Senior-Design-ZotPonics/Documentation/images/T-Cobbler2.jpg

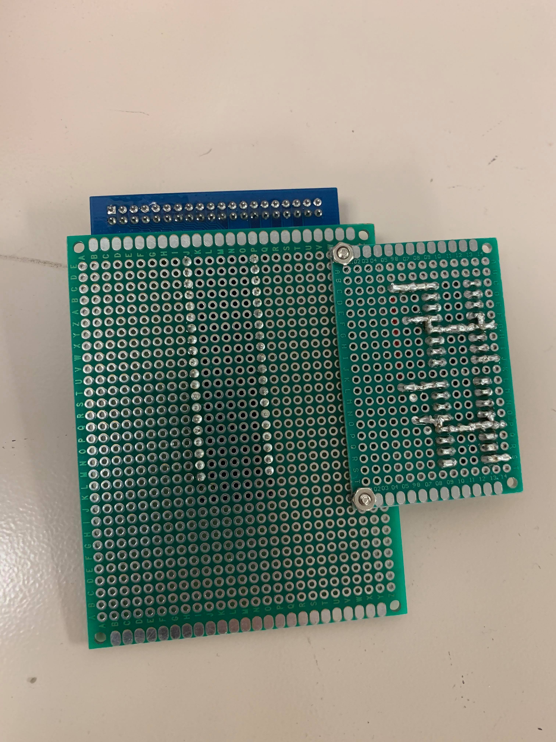
images/T-Cobbler2.jpg
