Senior-Design-ZotPonics/Documentation/T-Cobbler1.jpg

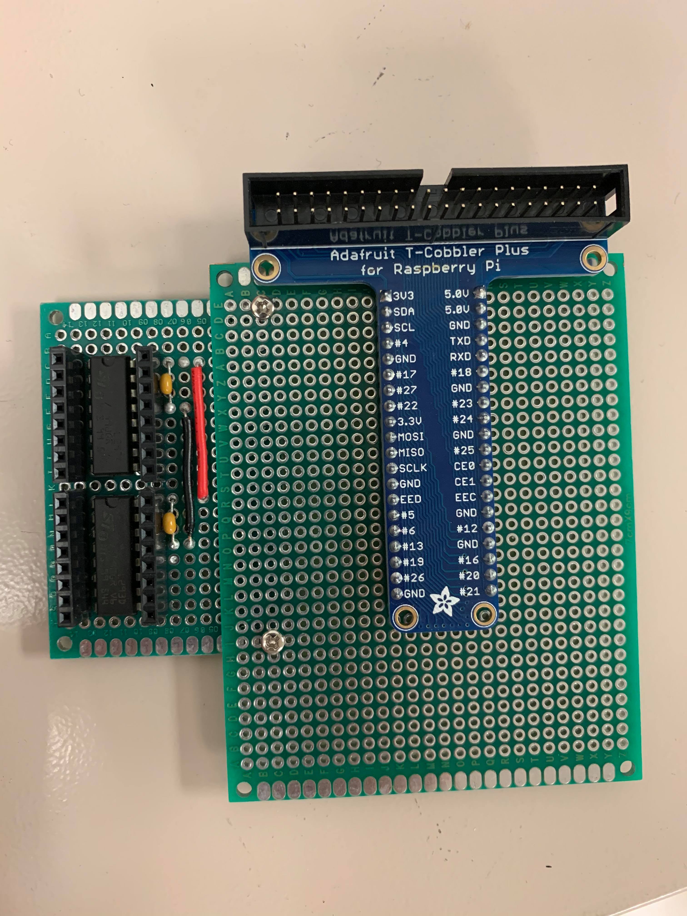
T-Cobbler1.jpg
