Senior-Design-ZotPonics/Documentation/App Hierarchy.png

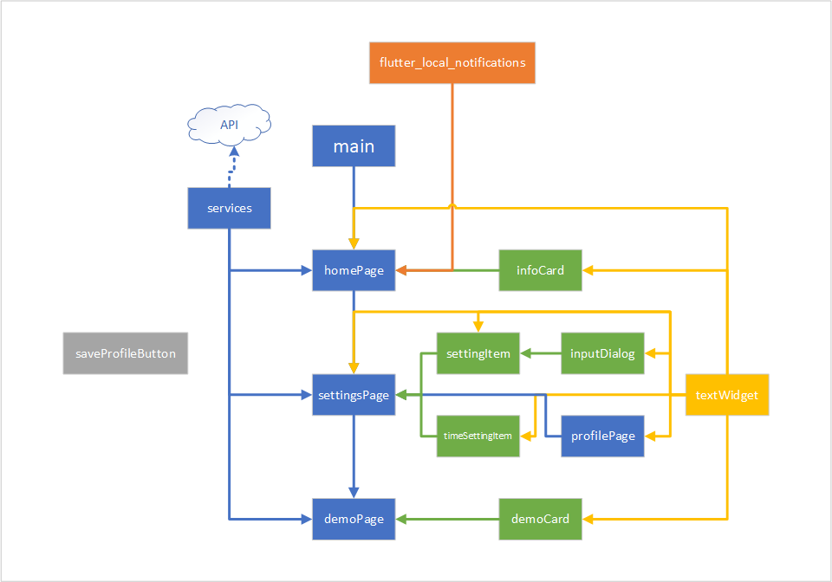
App Hierarchy.png
