Senior-Design-ZotPonics/Documentation/App Recording.gif

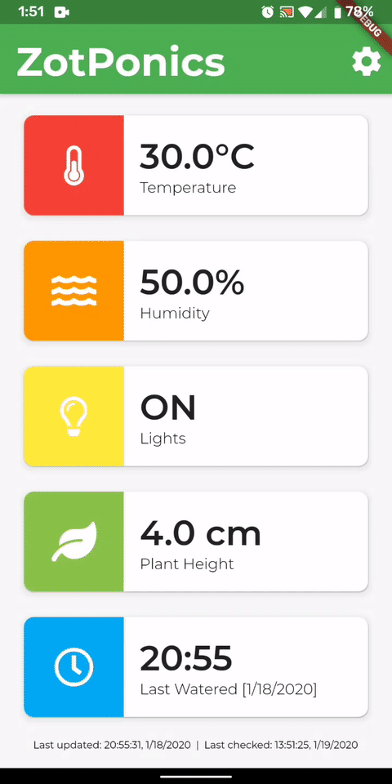
App Recording.gif
