Senior-Design-ZotPonics/Documentation/mobile app 2.0 hierarchy.jpg

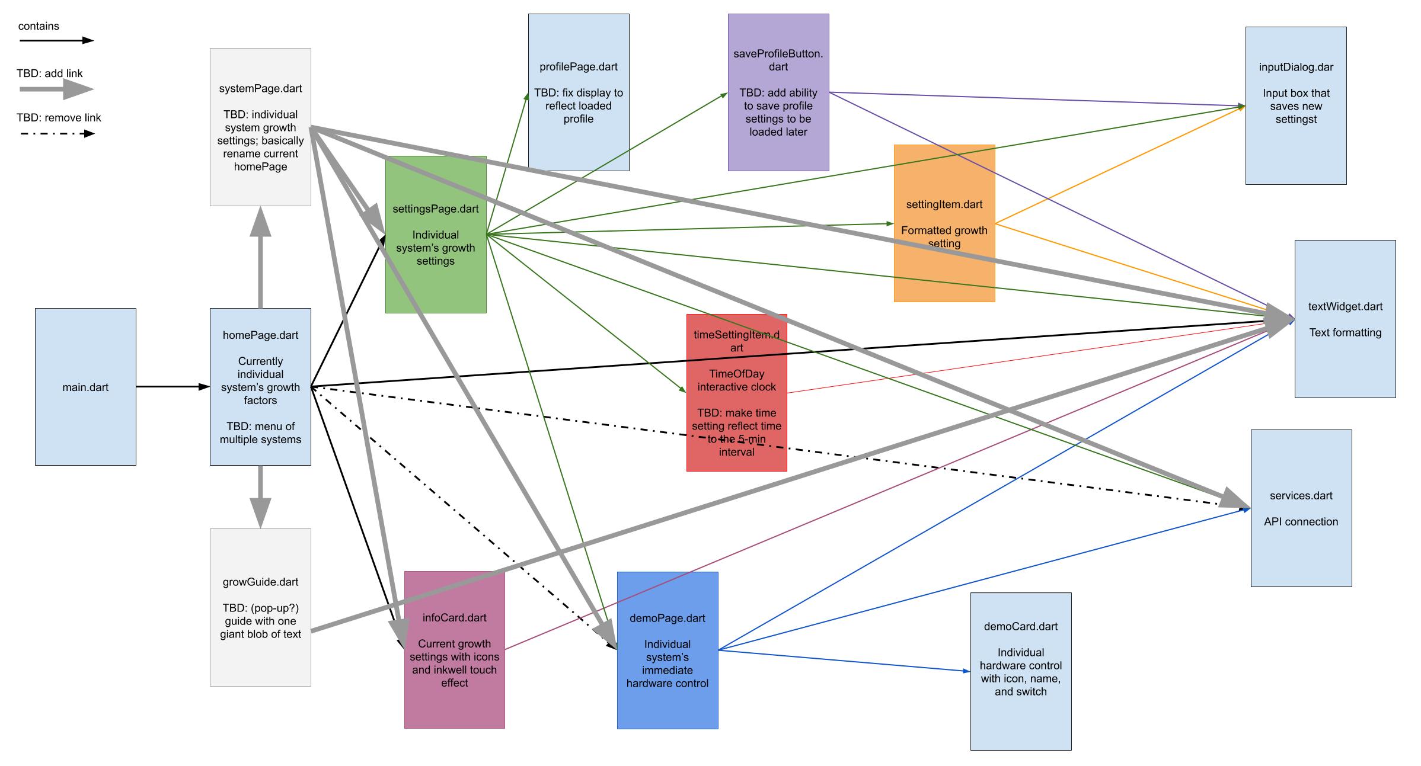
mobile app 2.0 hierarchy.jpg
