Senior-Design-ZotPonics/Documentation/Motor Driver Connections.PNG

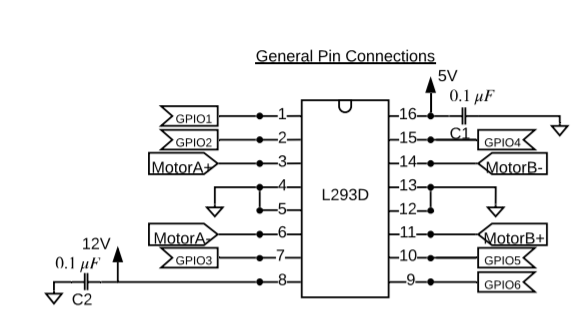
Motor Driver Connections.PNG
