Senior-Design-ZotPonics/Documentation/Truth Table for Motor Driver.PNG

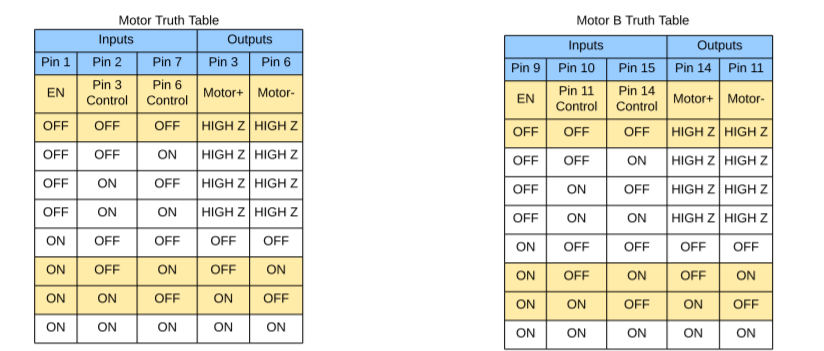
Truth Table for Motor Driver.PNG
