Senior-Design-ZotPonics/Documentation/Hardware/Components/PowerSystem_Diagram.pdf

5V rail from Pi can supply max 1.5 A

GND1

120 VAC
60 Hz

Since the Raspbery Pi adapter and 120 VAC to 12 VDC are plugged into different outlets, nonideal resistances between the two grounds cause small but non-negligible voltage differences (small 60 Hz oscillations). This small different is enough to cause communication issues between electronics with different ground references.

1. Sum all currents.
2. Choose AC to DC converter able to supply desired current.
3. Choose DC to DC converter able to supply desired current (If this converter is necessary)
4. Do not attempt to solder 120 VAC or build your own 120 VAC converter. Commerical power converters are certified to convert 120 VAC safely and efficiently.

Design by
Jason Lim and Kathy Nguyen 11/25/19

# Hydroponics Power System

60 Hz 120 VAC
to
5 VDC

~6 A

12 VDC
to
5 VDC

~700 mA

120 VAC
60 Hz

GND2

60 Hz 120 VAC
to
5 VDC

5 VDC
Raspberry Pi

2.5 A (max)

12 VDC Lights

12 VDC Pump

5 VDC Fan

5 VDC Fan

12 VDC
Solenoid Valve

1A

600 mA

3A

280 mA

280 mA

5 VDC
Ultrasonic
Sensor

15 mA

5 VDC
Microservo

200 mA

5 VDC
Microservo

200 mA

5 VDC
Temp/Humidity

2.5 mA
