Senior-Design-ZotPonics/Documentation/Hardware/Components/FOD8343D_Optoisolator_SolenoidValve_Diagram.pdf

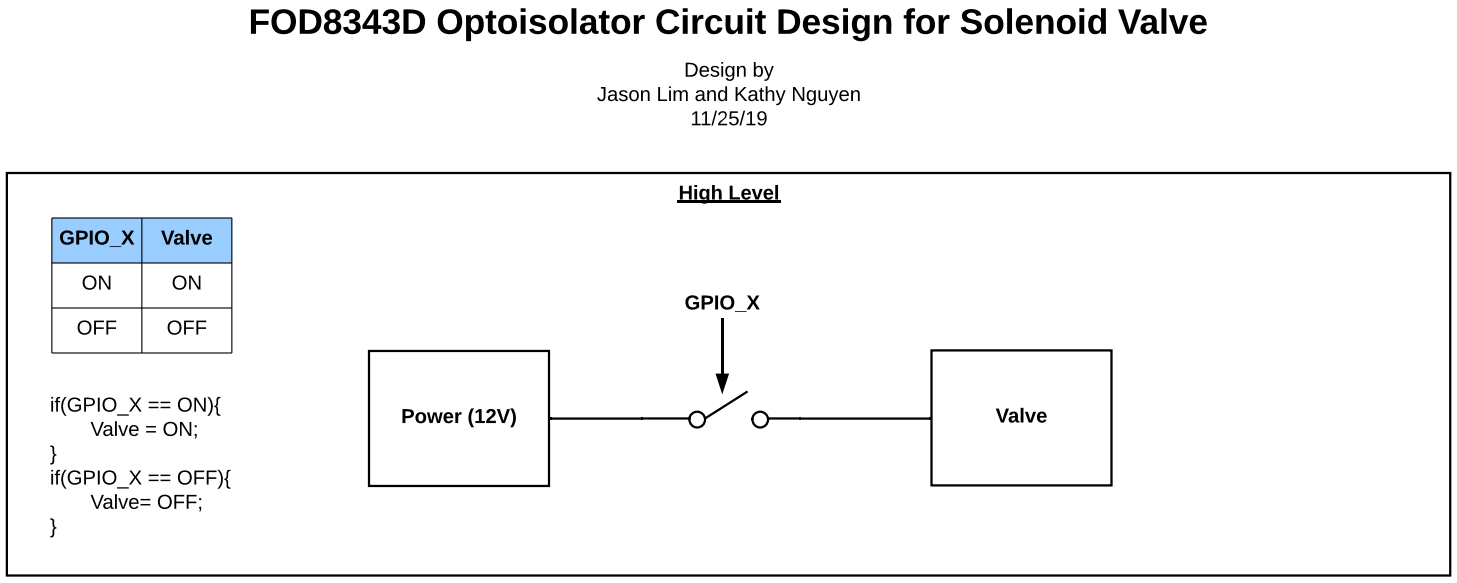
[picture p8: figure]
if(GPIO_X == ON){ Valve = ON;; } if(GPIO_X == OFF){ Valve= OFF;; Design by Jason Lim and Kathy Nguyen 11/25/19; High Level; GPIO_X; Valve; OFF; Power (12V)

Gnd1 and Gnd2 references do not need to be at the same voltage GPIO signal is electrically isolated from 12V power supply

Logic is not inverted, high at the input creates high at the output

Push-pull CMOS Logic

Requirements for Operation.
For safe operation, Io, VDD, and IF, should not be close to their max/min values

Resistance value calculated with assumption that LED forward voltage is 0.7 volts, desired current is 13 mA,
and GPIO output voltage from Pi is 5 volts. | x

Low Level

# FOD8343D Optoisolator Circuit Design for Solenoid Valve

Power+

Valve

1

2

GND

GPIO Input From Pi
(5V)

Gnd1

3
Gnd2

GPIO_X

VO
5

6

VDD

VSS
4
Gnd2

R 330 ?

Vin
1
IF

Io

N.C

2

Resistance value
calculation workflow

Solenoid valve is inductive (current inertia). Diode provides a path for the current as the magnetic field in the inductor dissipates (flyback diode).

## ON Semiconductor Datasheet Snippets for FOD8343D Optoisolator

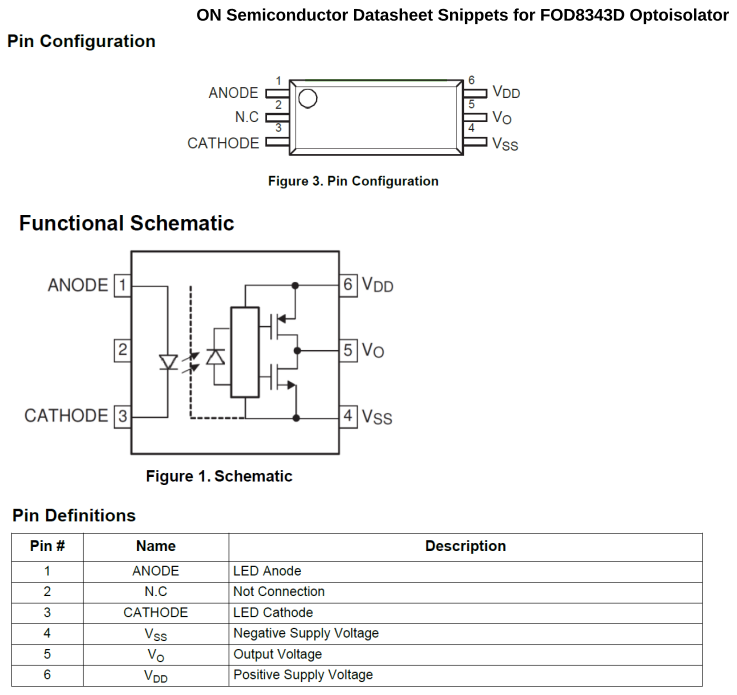
[picture p9: page 2]

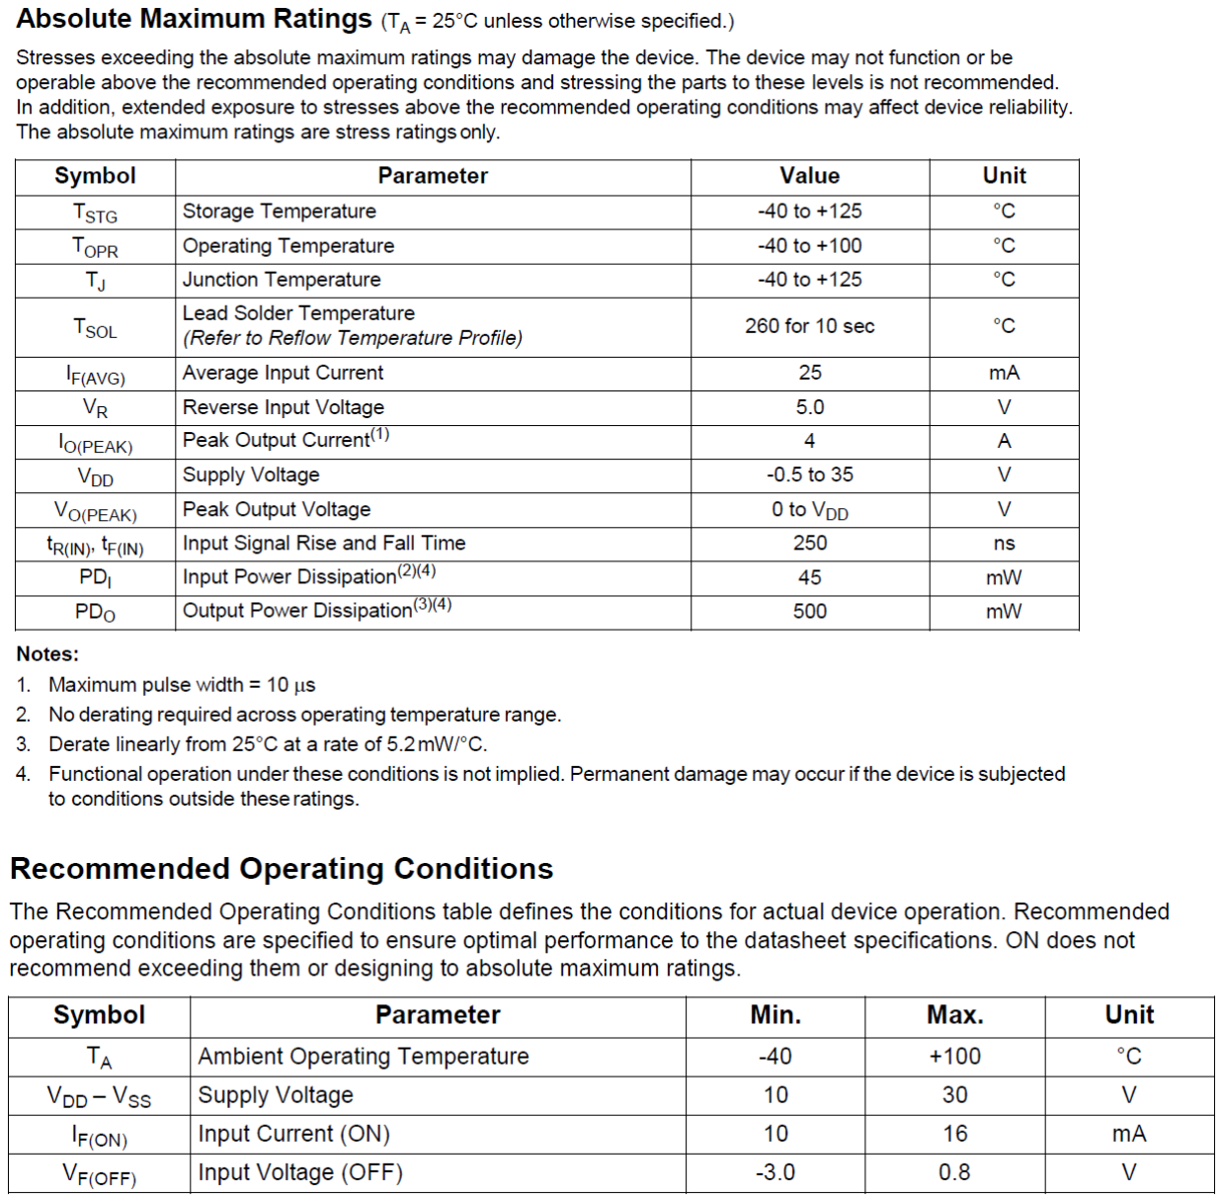
[picture p10: page 3]
