Senior-Design-ZotPonics/Documentation/Hardware/Components/FOD8343D_Optoisolator_Lights_Diagram.pdf

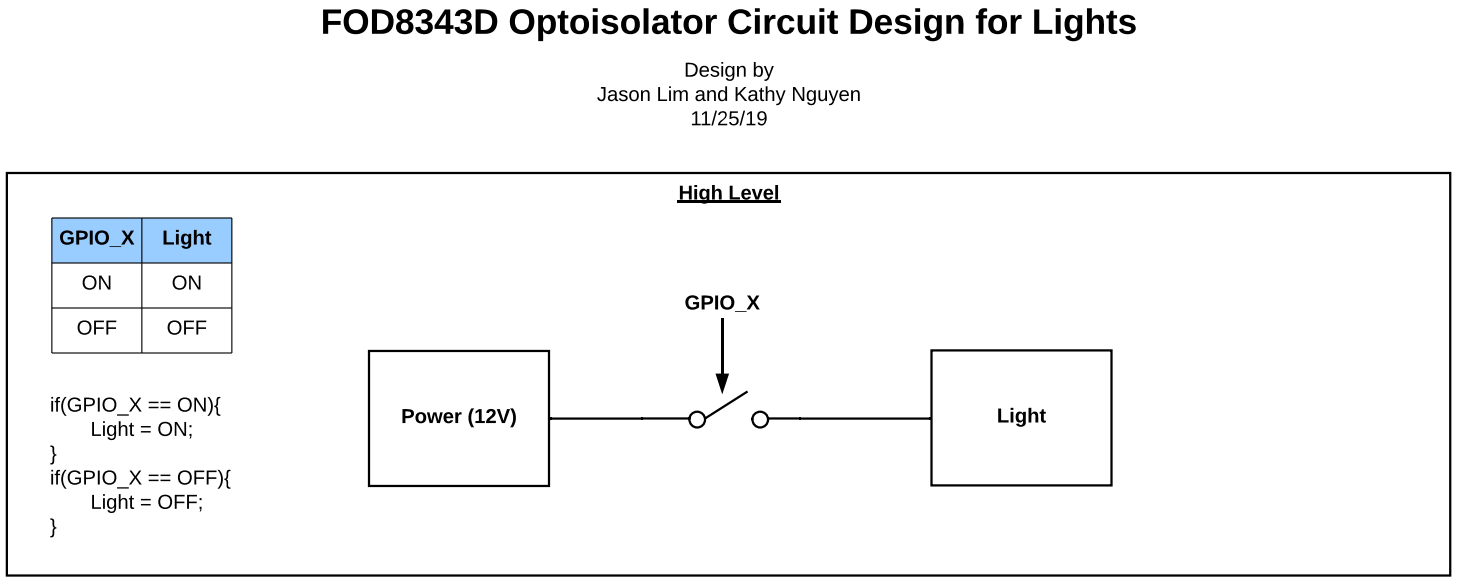
[picture p11: figure]
if(GPIO_X == ON){ Light = ON;; } if(GPIO_X == OFF){ Light = OFF;; Design by Jason Lim and Kathy Nguyen 11/25/19; High Level; GPIO_X; Light; OFF; Power (12V)
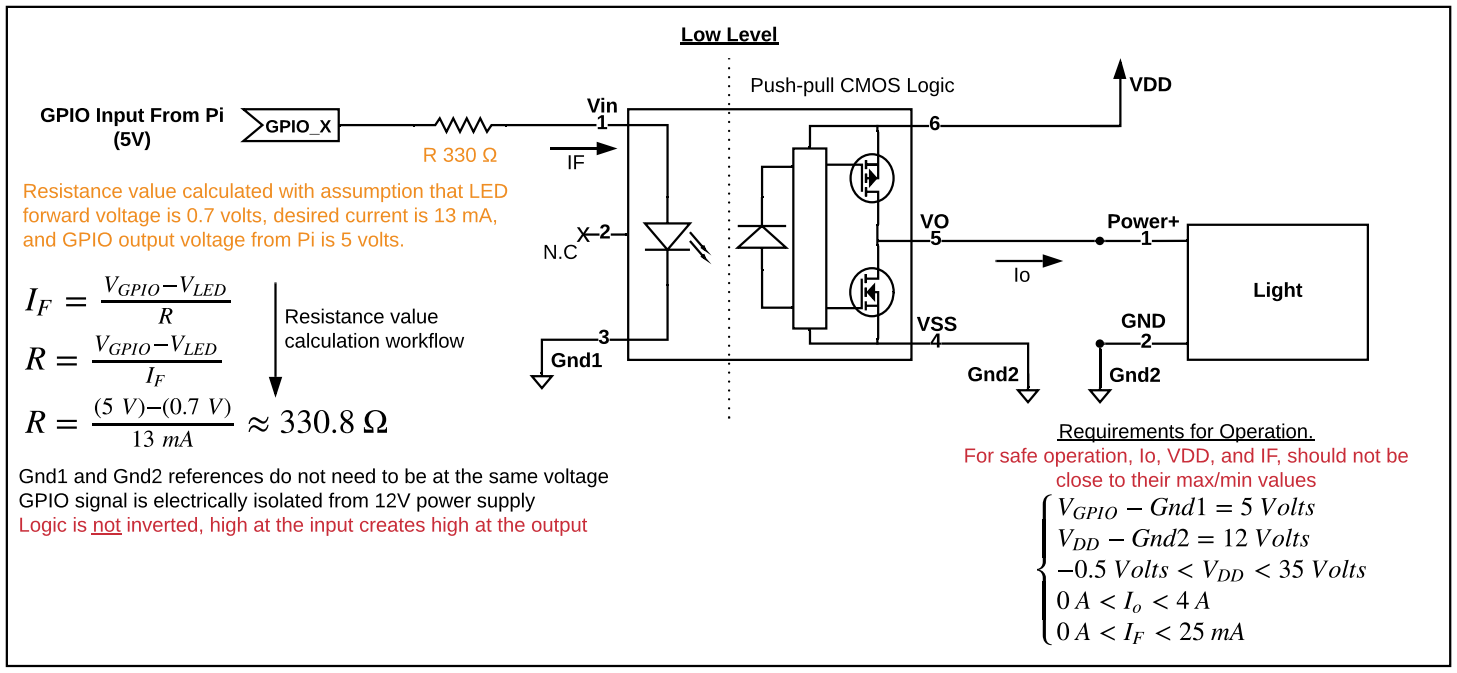
[picture p12: figure]
Push-pull CMOS Logic; Requirements for Operation.; close to their max/min values; Low Level; Power+; Light; GND; GPIO Input From Pi (5V); Gnd1; Gnd2; GPIO_X; VDD; VSS 4; Vin 1; Resistance value calculation workflow

Gnd1 and Gnd2 references do not need to be at the same voltage GPIO signal is electrically isolated from 12V power supply

Logic is not inverted, high at the input creates high at the output

For safe operation, Io, VDD, and IF, should not be

Resistance value calculated with assumption that LED forward voltage is 0.7 volts, desired current is 13 mA,
and GPIO output voltage from Pi is 5 volts. | x

# FOD8343D Optoisolator Circuit Design for Lights

## ON Semiconductor Datasheet Snippets for FOD8343D Optoisolator
