Senior-Design-ZotPonics/Documentation/Hardware/Components/L293D_MotorDriver_Diagram.pdf

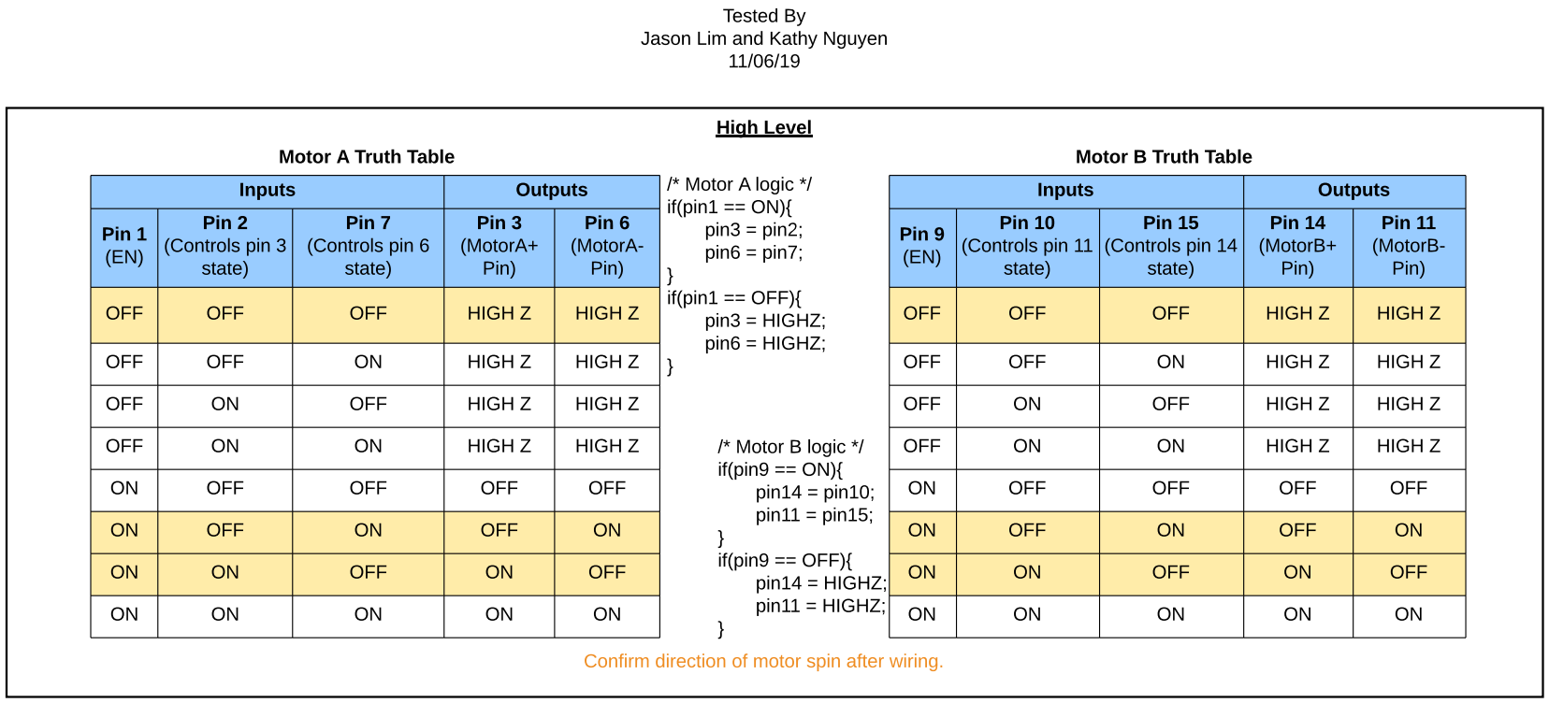
[picture p13: figure]
Motor A Truth Table; /* Motor A logic */ if(pin1 == ON){ pin3 = pin2; pin6 = pin7;; } if(pin1 == OFF){ pin3 = HIGHZ; pin6 = HIGHZ;; Tested By Jason Lim and Kathy Nguyen 11/06/19; Inputs; Outputs; Pin 1 (EN); Pin 2 (Controls pin 3 state); Pin 7 (Controls pin 6 state); Pin 3 (MotorA+ Pin); Pin 6 (MotorA- Pin); OFF; HIGH Z; Motor B Truth Table; Pin 9 (EN); Pin 10 (Controls pin 11 state); Pin 15 (Controls pin 14 state); Pin 14 (MotorB+ Pin); Pin 11 (MotorB- Pin); High Level; /* Motor B logic */ if(pin9 == ON){ pin14 = pin10; pin11 = pin15;; } if(pin9 == OFF){ pin14 = HIGHZ; pin11 = HIGHZ;

C1 and C2 AC bypass caps should be placed as close as possible to IC pins 8 and 16 respectively. Pin 16 must be at 5V (Internal logic voltage).
Pin 8 should be the voltage needed to drive motors A and B. Voltage must not exceed 36V.
600 mA current MAX per motor (both motors can be on at 600mA for a max of 1.2 A).

Confirm direction of motor spin after wiring.

L293D

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
MotorA+

GPIO_W

GPIO_U

GPIO_V

GPIO_Z

GPIO_X

GPIO_Y

MotorA-

MotorB-

MotorB+

Low Level

C1

C2

Back emf is handled in driver. Motor A and motor B can work at the same time if needed.

# L293D Motor Driver

The voltages at pins 3,6,11,14 will be the voltage at pin 8 when

these pins are HIGH/ON. Otherwise, voltage at ground

(zero) if LOW/OFF.

## Texas Instruments Datasheet Information Snippets for L293D Motor Drivers

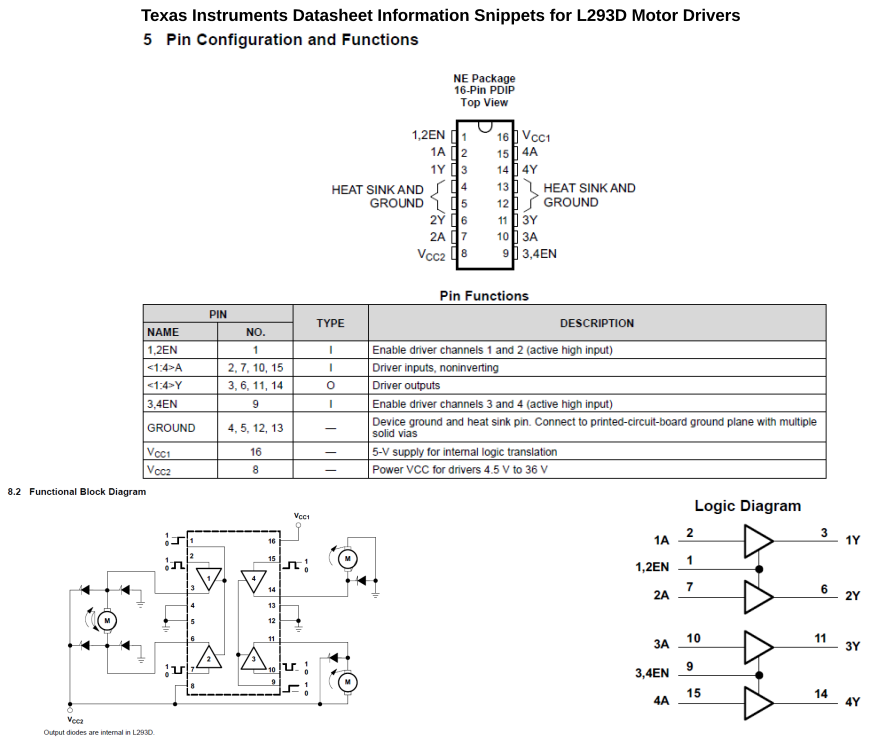
[picture p14: page 2]

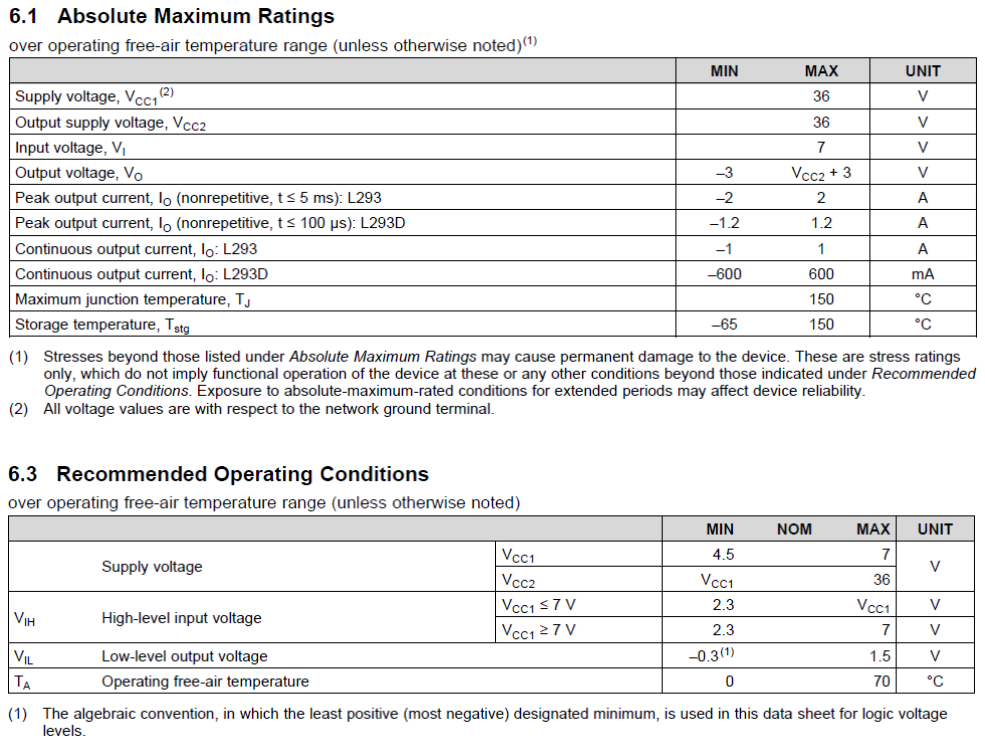
[picture p15: page 3]
