Senior-Design-ZotPonics/Documentation/Hardware/Components/HCSR04_UltrasonicSensor_Diagram.pdf

# HCSR04 Ultrasonic Sensor Circuit Diagram

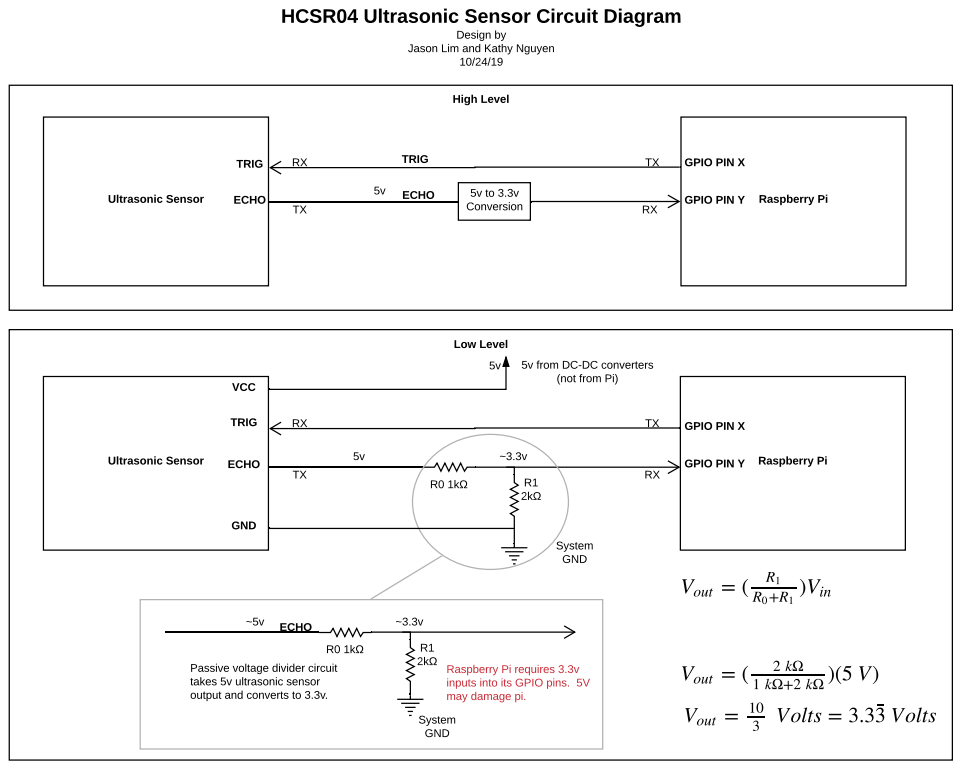
[picture p16: page 1]
Design by; ECHO; TRIG; Ultrasonic Sensor; Raspberry Pi; High Level; 5v to 3.3v Conversion; Low Level; System GND; GND; VCC; GPIO PIN X; GPIO PIN Y

Jason Lim and Kathy Nguyen

5v from DC-DC converters
(not from Pi)

Raspberry Pi requires 3.3v
inputs into its GPIO pins. 5V may damage pi.

Passive voltage divider circuit
takes 5v ultrasonic sensor
output and converts to 3.3v.
