Senior-Design-ZotPonics/Documentation/Hardware/PCB/MainBoard.sch

## EAGLE design Hardware/PCB/MainBoard.sch (2020-06-05)

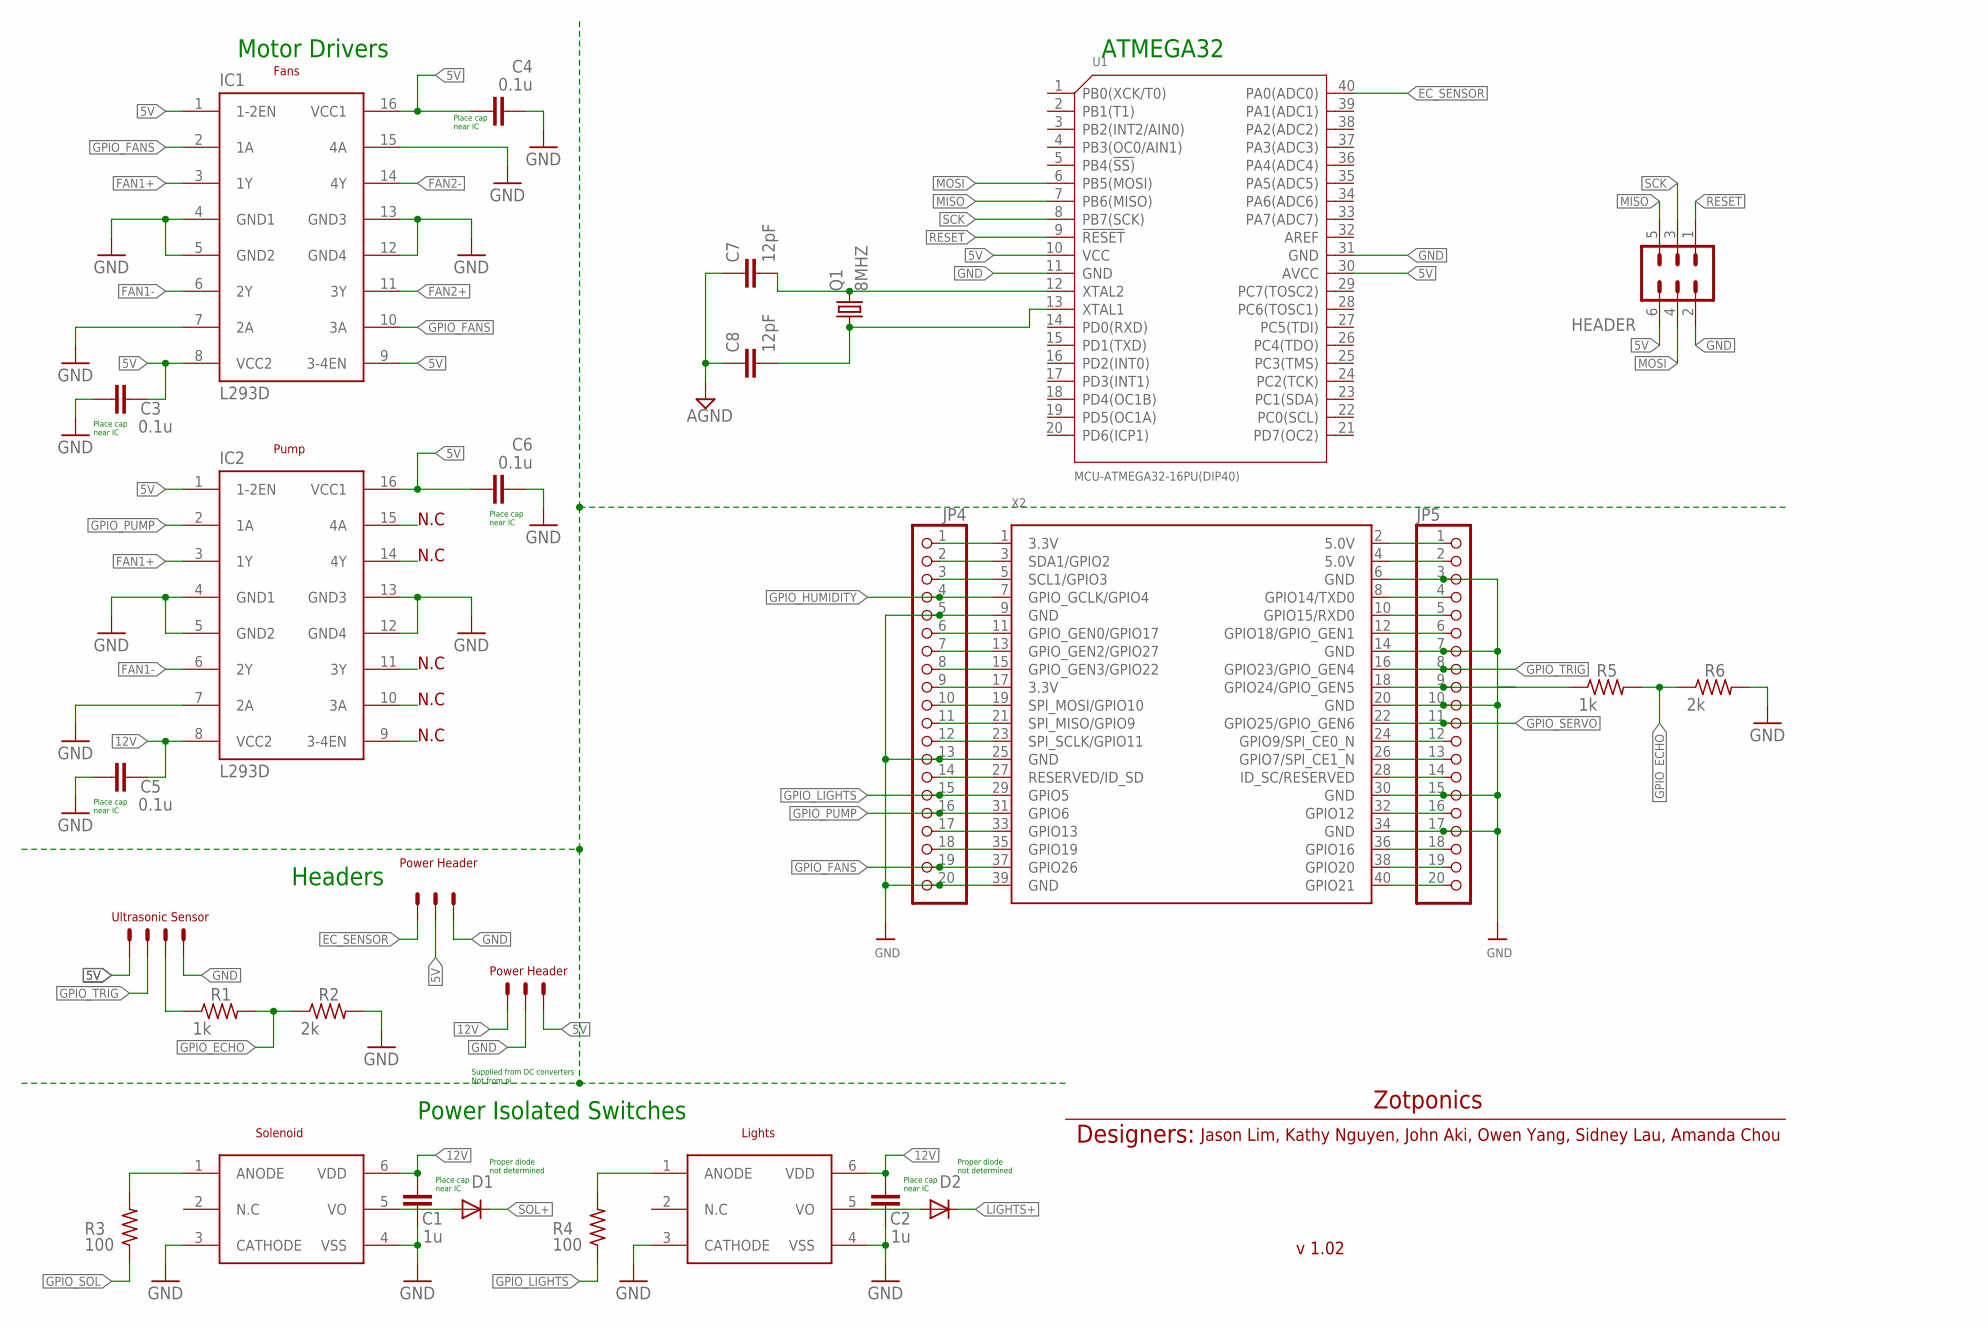
[picture p17: schematic MainBoard.sch, sheet 1]

Parts:
C1, C2: 1u; C2.5-3
C3, C4, C5, C6: 0.1u; C2.5-3
C7, C8: 12pF; C2.5-3
D1, D2: 1N4004; DO41-10
HEADER: MA03-2
IC1, IC2: L293D; DIL16
JP4, JP5: HEADER-1X20ROUND; 1X20_ROUND
Q1: 8MHZ; HC49/S
R1, R5: 1k; 0204V
R2, R6: 2k; 0204V
R3, R4: 100; 0204V
U1: MCU-ATMEGA32-16PU(DIP40); DIP40-2.54-52.3X15.24MM
U$1, U$3: FOD8343
X1: JST-XH-04-PIN-ROUND-PAD; JST-XH-04-PACKAGE-ROUND-PAD
X2: RASPBERRYPI_B+_IDC
X3, X4: JST-XH-03-PIN-ROUND-PAD; JST-XH-03-PACKAGE-ROUND-PAD

Connections:
5V: C3.2, C4.1, C6.1, HEADER.6, IC1.1 (1-2EN), IC1.8 (VCC2), IC1.9 (3-4EN), IC1.16 (VCC1), IC2.1 (1-2EN), IC2.9 (3-4EN), IC2.16 (VCC1), U1.10 (VCC), U1.30 (AVCC), X1.1, X3.3, X4.2
12V: C1.2, C2.2, C5.2, IC2.8 (VCC2), U$1.6 (VDD), U$3.6 (VDD), X3.1
EC_SENSOR: U1.40 (PA0(ADC0)), X4.1
FAN1+: IC1.3 (1Y), IC2.3 (1Y)
FAN1-: IC1.6 (2Y), IC2.6 (2Y)
FAN2+: IC1.11 (3Y), IC2.11 (3Y)
FAN2-: IC1.14 (4Y), IC2.14 (4Y)
GND: C1.1, C2.1, C3.1, C4.2, C5.1, C6.2, HEADER.2, IC1.4 (GND1), IC1.5 (GND2), IC1.7 (2A), IC1.12 (GND4), IC1.13 (GND3), IC2.4 (GND1), IC2.5 (GND2), IC2.7 (2A), IC2.12 (GND4), IC2.13 (GND3), JP4.5, JP4.13, JP4.20, JP5.3, JP5.7, JP5.10, JP5.15, JP5.17, R2.2, R6.2, U1.11 (GND), U1.31 (GND), U$1.3 (CATHODE), U$1.4 (VSS), U$3.3 (CATHODE), U$3.4 (VSS), X1.4, X2.6 (GND), X2.9 (GND), X2.14 (GND), X2.20 (GND), X2.25 (GND), X2.30 (GND), X2.34 (GND), X2.39 (GND), X3.2, X4.3
GPIO_ECHO: R1.2, R2.1, R5.2, R6.1
GPIO_FANS: IC1.2 (1A), IC1.10 (3A), IC2.10 (3A), JP4.19, X2.37 (GPIO26)
GPIO_HUMIDITY: JP4.4, X2.7 (GPIO_GCLK/GPIO4)
GPIO_LIGHTS: JP4.15, R4.1, X2.29 (GPIO5)
GPIO_PUMP: IC2.2 (1A), JP4.16, X2.31 (GPIO6)
GPIO_SERVO: JP5.11, X2.22 (GPIO25/GPIO_GEN6)
GPIO_SOL: R3.1
GPIO_TRIG: JP5.8, X1.2, X2.16 (GPIO23/GPIO_GEN4)
LIGHTS+: D2.C
MISO: HEADER.5, U1.7 (PB6(MISO))
MOSI: HEADER.4, U1.6 (PB5(MOSI))
unnamed: R3.2, U$3.1 (ANODE)
unnamed: D2.A, U$1.5 (VO)
unnamed: D1.A, U$3.5 (VO)
unnamed: R4.2, U$1.1 (ANODE)
unnamed: JP5.2, X2.4 (5.0V)
unnamed: R1.1, X1.3
unnamed: C7.2, Q1.2, U1.12 (XTAL2)
unnamed: C8.2, Q1.1, U1.13 (XTAL1)
unnamed: JP5.4, X2.8 (GPIO14/TXD0)
unnamed: JP5.5, X2.10 (GPIO15/RXD0)
unnamed: JP5.6, X2.12 (GPIO18/GPIO_GEN1)
unnamed: JP5.9, X2.18 (GPIO24/GPIO_GEN5)
unnamed: C7.1, C8.1
unnamed: JP5.12, X2.24 (GPIO9/SPI_CE0_N)
unnamed: JP5.13, X2.26 (GPIO7/SPI_CE1_N)
unnamed: JP5.14, X2.28 (ID_SC/RESERVED)
unnamed: JP5.16, X2.32 (GPIO12)
unnamed: JP5.18, X2.36 (GPIO16)
unnamed: JP5.19, X2.38 (GPIO20)
unnamed: JP5.20, X2.40 (GPIO21)
unnamed: JP4.1, X2.1 (3.3V)
unnamed: JP4.2, X2.3 (SDA1/GPIO2)
unnamed: JP4.3, X2.5 (SCL1/GPIO3)
unnamed: JP4.6, X2.11 (GPIO_GEN0/GPIO17)
unnamed: JP4.7, X2.13 (GPIO_GEN2/GPIO27)
unnamed: JP4.8, X2.15 (GPIO_GEN3/GPIO22)
unnamed: JP4.9, X2.17 (3.3V)
unnamed: JP4.10, X2.19 (SPI_MOSI/GPIO10)
unnamed: JP4.11, X2.21 (SPI_MISO/GPIO9)
unnamed: JP4.12, X2.23 (SPI_SCLK/GPIO11)
unnamed: JP4.14, X2.27 (RESERVED/ID_SD)
unnamed: JP4.17, X2.33 (GPIO13)
unnamed: JP4.18, X2.35 (GPIO19)
unnamed: JP5.1, X2.2 (5.0V)
RESET: HEADER.1, U1.9 (!RESET)
SCK: HEADER.3, U1.8 (PB7(SCK))
SOL+: D1.C

Notes on the sheet:
Motor Drivers
Fans
Pump
N.C
Power Isolated Switches
ATMEGA32
Solenoid
Lights
Headers
Zotponics
Designers:
Jason Lim, Kathy Nguyen, John Aki, Owen Yang, Sidney Lau, Amanda Chou
v 1.02
Ultrasonic Sensor
Place cap near IC
Proper diode not determined
Power Header
Supplied from DC converters Not from pi

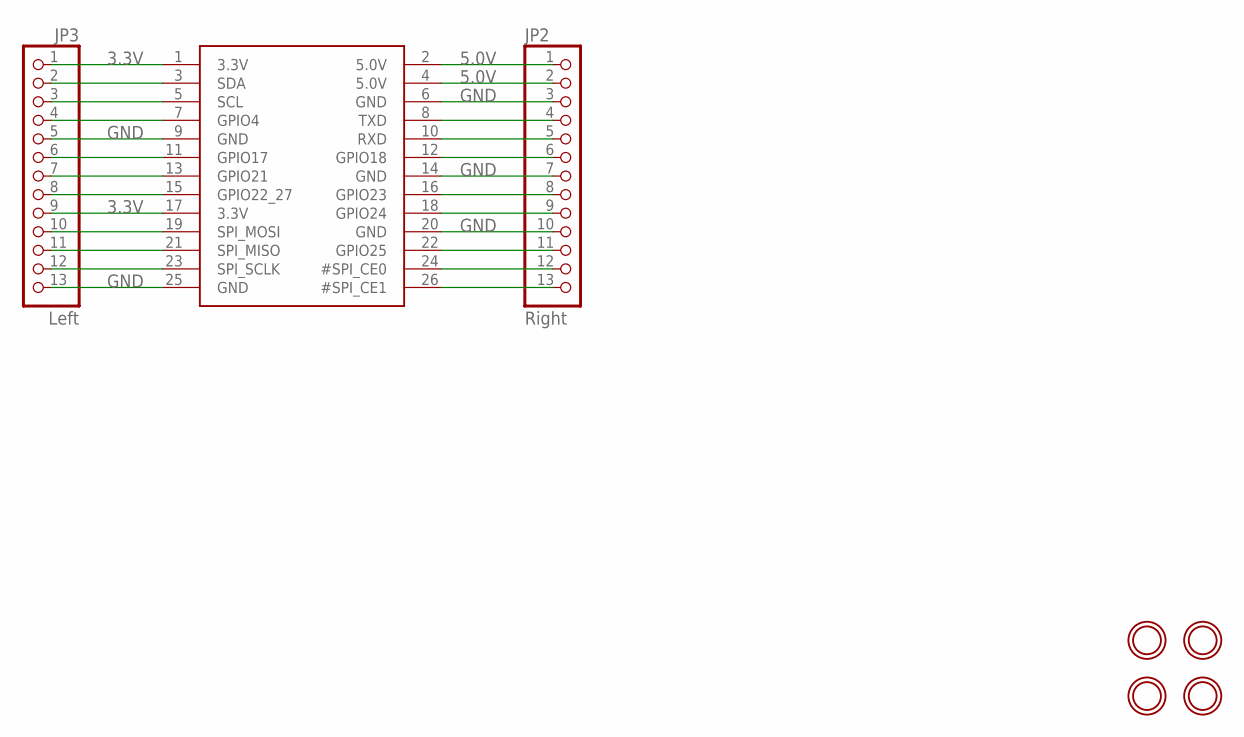
[picture p18: schematic MainBoard.sch, sheet 2]

Parts:
JP1: PI; RASBERRYPI_IDC
JP2: Right; 1X13_ROUND_70
JP3: Left; 1X13_ROUND_70
U$4, U$5, U$6, U$7: MOUNTINGHOLE2.5; MOUNTINGHOLE_2.5_PLATED

Connections:
3.3V: JP1.1 (3.3V), JP1.17 (3.3V), JP3.1, JP3.9
5.0V: JP1.2 (5.0V), JP1.4 (5.0V), JP2.1, JP2.2
GND: JP1.6 (GND), JP1.9 (GND), JP1.14 (GND), JP1.20 (GND), JP1.25 (GND), JP2.3, JP2.7, JP2.10, JP3.5, JP3.13
unnamed: JP1.3 (SDA), JP3.2
unnamed: JP1.5 (SCL), JP3.3
unnamed: JP1.7 (GPIO4), JP3.4
unnamed: JP1.11 (GPIO17), JP3.6
unnamed: JP1.13 (GPIO21), JP3.7
unnamed: JP1.15 (GPIO22_27), JP3.8
unnamed: JP1.19 (SPI_MOSI), JP3.10
unnamed: JP1.21 (SPI_MISO), JP3.11
unnamed: JP1.23 (SPI_SCLK), JP3.12
unnamed: JP1.8 (TXD), JP2.4
unnamed: JP1.10 (RXD), JP2.5
unnamed: JP1.12 (GPIO18), JP2.6
unnamed: JP1.16 (GPIO23), JP2.8
unnamed: JP1.18 (GPIO24), JP2.9
unnamed: JP1.22 (GPIO25), JP2.11
unnamed: JP1.24 (#SPI_CE0), JP2.12
unnamed: JP1.26 (#SPI_CE1), JP2.13
