Senior-Design-ZotPonics/Documentation/(threads)

Thread 5 (2020-05-25):

ATMEGA32 oscillator capacitor values

JasonLim1, 2020-05-25:

Thread 7 (2020-05-25):

Determine Oscillator Capacitor Values

JasonLim1, 2020-05-25:

Thread 9 (2020-05-25):

Examine programming ATMEGA32 with Pi

JasonLim1, 2020-05-25:

chouamandak, 2020-05-31:
https://ozzmaker.com/program-avr-using-raspberry-pi-gpio/
- install arduino ide and avrdude
- compile and upload generated .hex file
OR
- install arduino ide, avrdude, and arduino makefile
- put make commands to compile and upload in a makefile

Closed 2020-05-31.
