Senior-Design-ZotPonics/Documentation/(commit log)

2020-05-17 MainBoard_V1.0
    Added Motor Drivers, Optoisolators, and skeleton for ATMEGA382
    [MainBoard_V1.0.sch]
2020-05-18 MainBoard_V1.01
    C1 & C2 = 1uf
    C3, C4, C5, C6 = 0.1 uF
    R1 = 1K, R2 = 2k
    Added labels and descriptions
    Added power header
    Fixes optoisolators pin 4 and 6 connections
    [MainBoard_V1.01.sch]
2020-05-18 HCSR04(UltrasonicSensor)
    Datasheet for the ultrasonic sensor
2020-05-18 L293D(MotorDriver)
    Datasheet for the motor driver.
2020-05-18 DHT11(HumidityTempSesor)
    Datasheet for the humidity and temperature sensor.
2020-05-18 15281280ND(SolenoidValve)
    Datasheet for the solenoid Valve.
2020-05-23 PCB board changes
    [MainBoard.sch]
2020-05-24 Cleanup
    Use "MainBoard.sch" as main file.
    [MainBoard_V1.0.sch]
2020-06-05 Changes to PCB board
    [MainBoard.sch]
2020-07-10 Circuit Diagram for HCSR04 Ultrasonic Sensor
2020-07-10 Circuit Diagram for L293D Motor Driver
2020-07-13 Power Isolated Lights Circuit Diagram
2020-07-13 Power Isolated Solenoid Valve Circuit Diagram
2020-07-13 Power System Overview Diagram
2020-07-13 Instructions for Adding 120 VAC to 12V AC Converter
2020-07-13 Formatting Changes and Resistance calculations
2020-07-13 Flyback Diode Forward Biased from GND2 to Power+
2020-07-13 Added Reasoning for Naming GND1 and GND2.
